Armastardo/OpenMiniRectangle/PCB/Pictures/Rename.png

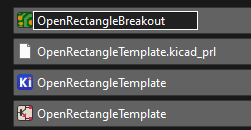
PCB/Pictures/Rename.png
