Armastardo/OpenMiniRectangle/PCB/model/RP2040_QFN_PACKAGE.STEP

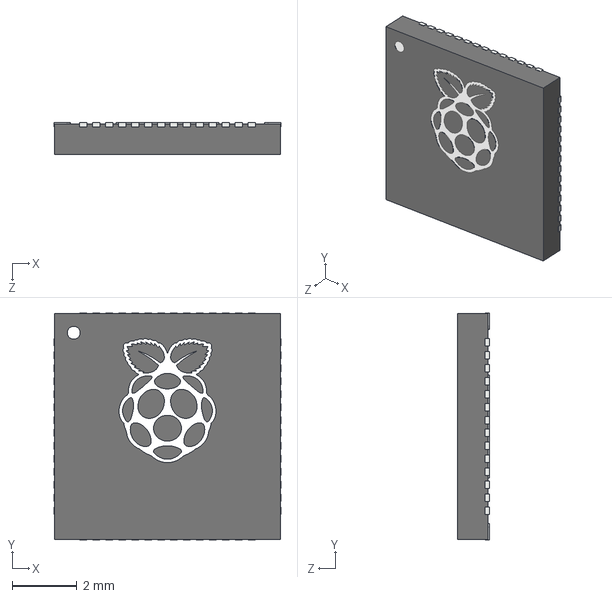
[picture p3: CAD file, 2023-03-23]
PCB/model/RP2040_QFN_PACKAGE.STEP
7.02 x 7.02 x 1.00 mm
