Armastardo/OpenMiniRectangle/PCB/OpenMiniRectangle.dxf

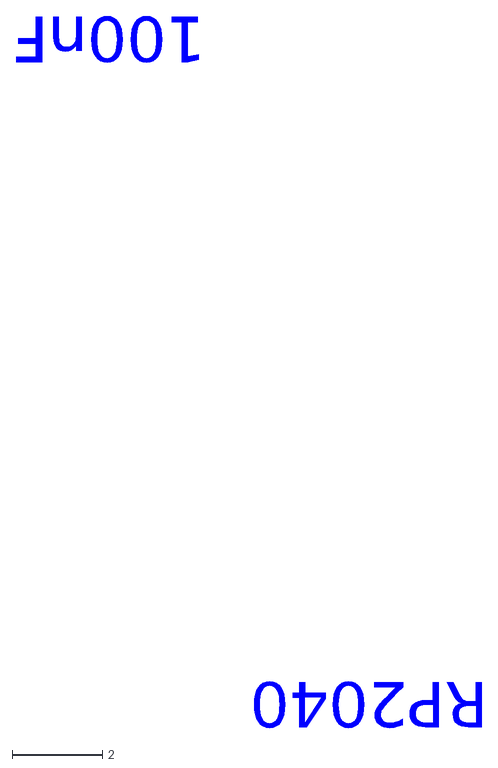
[picture p4: CAD file, 2023-03-23]
PCB/OpenMiniRectangle.dxf
100nF
RP2040
