Armastardo/OpenMiniRectangle/PCB/Resources/Small case reference.dxf

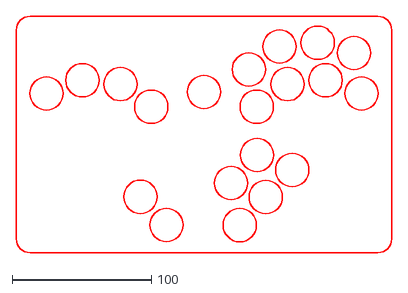
[picture p5: CAD file, 2023-03-23]
PCB/Resources/Small case reference.dxf
270.0 x 170.0
