Armastardo/OpenMiniRectangle/Case/Mini Rectangle v3.stl

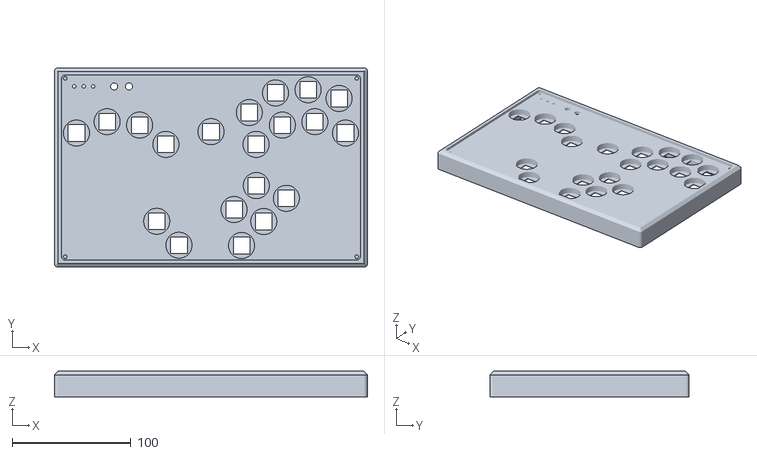
[picture p6: CAD file, 2023-07-12]
Case/Mini Rectangle v3.stl
263.6 x 168.0 x 21.5
