Armastardo/OpenMiniRectangle/(list of files, cad)

Other CAD files:
Case/BottomPanel.dwg
Case/TopPanel.dwg
