Armastardo/OpenMiniRectangle/DaughterBoard/MiniRectangleDB.kicad_pcb

## KiCad design DaughterBoard/MiniRectangleDB.kicad_pcb (2023-07-12)

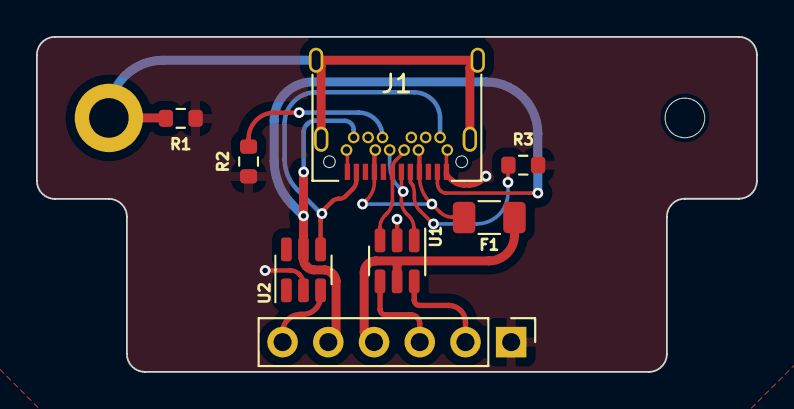
[picture p7: board MiniRectangleDB.kicad_pcb from above]

Board: 2 copper layers, 40.0 x 18.6 mm, 10 parts (0 on the bottom side), 13 nets.

Parts:
F1: 500 mA; Fuse_1206_3216Metric
H1: MountingHole; MountingHole_2.2mm_M2
H2: MountingHole_Pad; MountingHole_2.2mm_M2_DIN965_Pad
J1: USB C Connector; TYPE-C_24P_QCHT
J2: Conn_01x06; PinHeader_1x06_P2.54mm_Vertical
R1: 1M; R_0603_1608Metric
R2, R3: 5.1k; R_0603_1608Metric
U1, U2: USBLC6-2SC6; SOT-23-6

Connections:
3vCable: J1.A2 (TX1+), J1.B2 (TX2+), J2.5, U2.5 (VBUS)
+5V: F1.2, J2.4, U1.5 (VBUS)
D+: J2.2, U1.6 (I/O1)
D-: J2.3, U1.4 (I/O2)
DATA: J2.6, U2.3 (I/O2)
DATABUS: J1.A11 (RX2+), J1.B11 (RX1+), U2.4 (I/O2)
DBUS+: J1.A6 (D+), J1.B6 (D+), U1.1 (I/O1)
DBUS-: J1.A7 (D-), J1.B7 (D-), U1.3 (I/O2)
GND: J1.A1 (GND), J1.A12 (GND), J1.B1 (GND), J1.B12 (GND), J2.1, R1.1, R2.1, R3.2, U1.2 (GND), U2.2 (GND)
unnamed: F1.1, J1.A4 (VBUS), J1.A9 (VBUS), J1.B4 (VBUS), J1.B9 (VBUS)
unnamed: J1.A5 (CC1), R3.1
unnamed: J1.B5 (CC2), R2.2
unnamed: H2.1, J1.S1 (SHIELD), R1.2
