Armastardo/OpenMiniRectangle/PCB/OpenMiniRectangle.kicad_pcb

## KiCad design PCB/OpenMiniRectangle.kicad_pcb (2023-03-24)

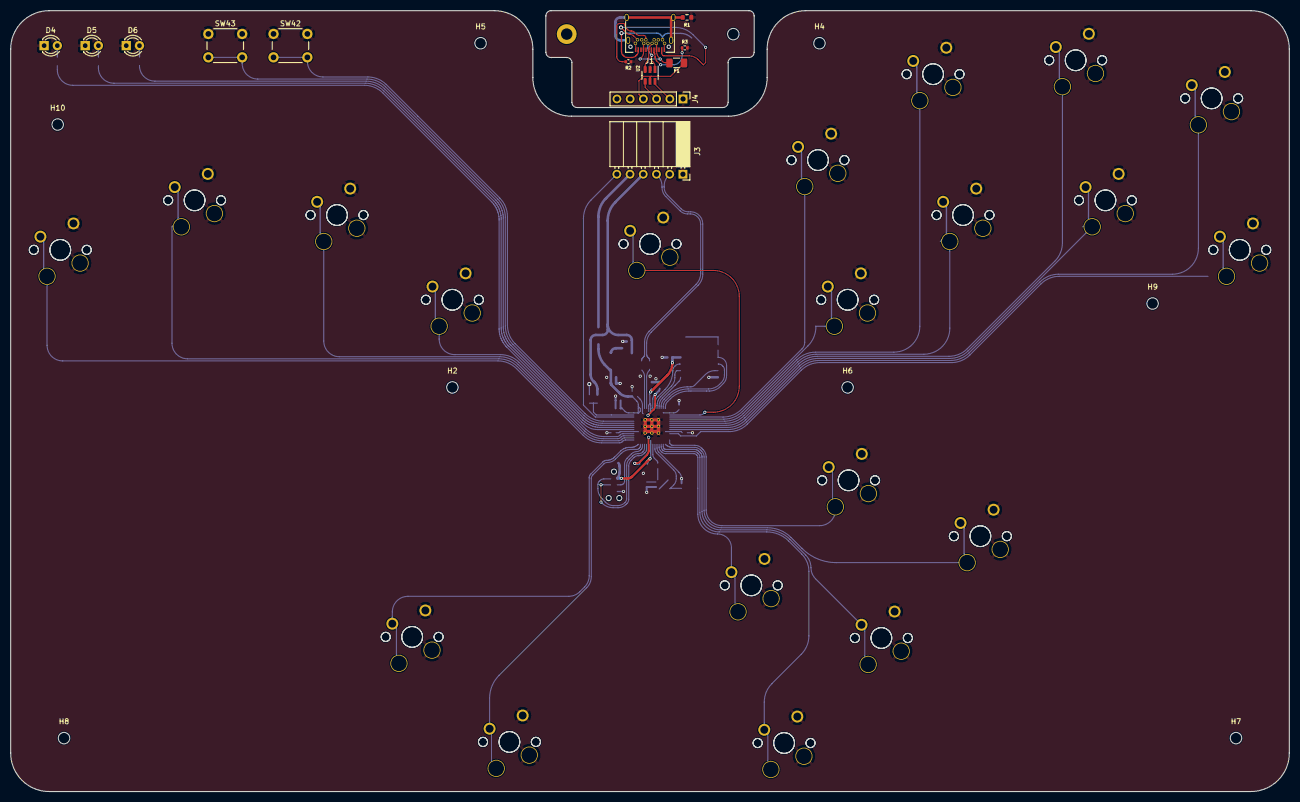
[picture p8: board OpenMiniRectangle.kicad_pcb from above]

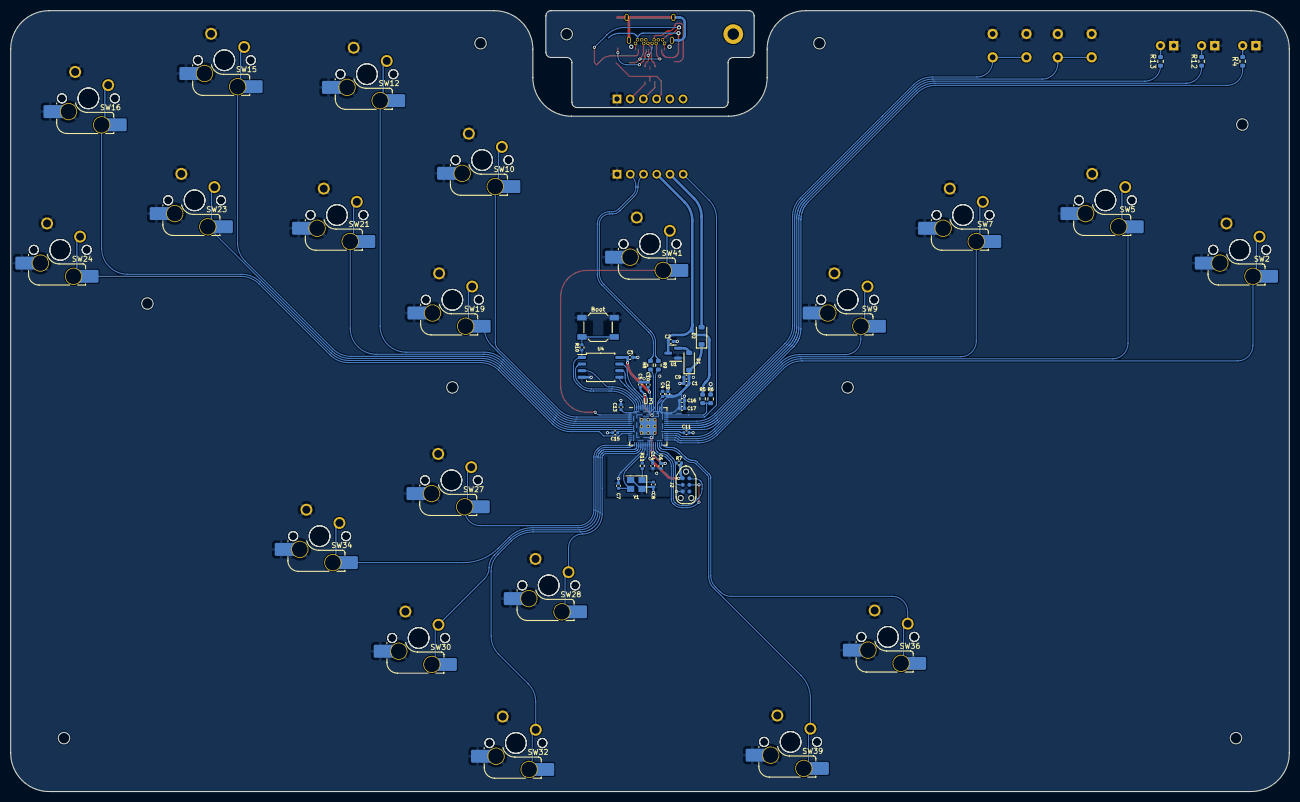
[picture p9: board OpenMiniRectangle.kicad_pcb from below]

Board: 2 copper layers, 245.6 x 150.0 mm, 98 parts (55 on the bottom side), 59 nets.

Parts:
C1, C2, C4, C10: 1uF; C_0402_1005Metric
C3, C5, C6, C11, C12, C13, C14, C15, C16, C17: 100nF; C_0402_1005Metric
C7, C8: 22pF; C_0402_1005Metric
C9: 10uF; C_0402_1005Metric
D1, D2: Schottky Diode; D_SOD-123
D4, D5, D6: LED; LED_D3.0mm
F1: 500 mA; Fuse_1206_3216Metric
H1, H2, H4, H5, H6, H7, H8, H9, H10: MountingHole; MountingHole_2.2mm_M2
H3: MountingHole_Pad; MountingHole_2.2mm_M2_DIN965_Pad
J1: USB C Connector; TYPE-C_24P_QCHT
J2: JTAG_TC2030; CON_TC2030_outlined
J3: Conn_01x06; PinSocket_1x06_P2.54mm_Horizontal
J4: Conn_01x06; PinHeader_1x06_P2.54mm_Vertical
R1: 1M; R_0603_1608Metric
R2, R3: 5.1k; R_0402_1005Metric
R4, R12, R13: 1k; R_0603_1608Metric
R5: 5.6k; R_0603_1608Metric
R6: 10k; R_0603_1608Metric
R7: 10k; R_0402_1005Metric
R8, R9: 27; R_0603_1608Metric
R10, R11: 1k; R_0402_1005Metric
SW1: Boot; SW_SPST_SKQG_WithStem
SW2, SW5, SW7, SW9, SW10, SW12, SW15, SW16, SW19, SW21, SW23, SW24, SW27, SW28, SW30, SW32, SW34, SW36, SW39, SW41: MX_SW_HS; SW_MX_HS_1u
SW3, SW4, SW6, SW8, SW11, SW13, SW14, SW17, SW18, SW20, SW22, SW25, SW26, SW29, SW31, SW33, SW35, SW37, SW38, SW40: MX_SW_solder; SW_MX_1u
SW42, SW43: SW_Push; SW_PUSH_6mm
U1: XC6206; SOT-23
U2: USBLC6-2SC6; SOT-23-6
U3: RP2040; RP2040-QFN-56
U4: W25Q128JVS; SOIC-8_5.23x5.23mm_P1.27mm
Y1: 12MHz; Crystal_SMD_3225-4Pin_3.2x2.5mm

Connections:
3vCable: D2.2 (A), J1.A2 (TX1+), J1.B2 (TX2+), J3.5, J4.5
+1V1: C4.1, C5.1, C6.1, U3.23 (DVDD), U3.45 (VREG_VOUT), U3.50 (DVDD)
+3V3: C1.2, C3.1, C9.1, C10.1, C11.1, C12.1, C13.1, C14.1, C15.1, C16.1, C17.1, D1.1 (K), D2.1 (K), J2.1 (VCC), R7.1, U3.1 (IOVDD), U3.10 (IOVDD), U3.22 (IOVDD), U3.33 (IOVDD), U3.42 (IOVDD), U3.43 (ADC_AVDD), U3.44 (VREG_VIN), U3.48 (USB_VDD), U3.49 (IOVDD), U4.8 (VCC)
+5V: C2.2, F1.2, J3.4, J4.4, R5.1, U1.3 (VI), U2.5 (VBUS)
/D_+: R8.2, U3.47 (D+)
/D_-: R9.2, U3.46 (D-)
/XTAL_O: C8.2, R11.1, Y1.1
/~USB_BOOT: R10.1, SW1.2
A: SW30.2, SW31.1, U3.16 (GPIO13)
B: SW18.1, SW19.2, U3.4 (GPIO2)
CS: R10.2, U3.56 (QSPI_SS_N), U4.1 (~CS)
C_DN: SW32.2, SW33.1, U3.17 (GPIO14)
C_LT: SW28.2, SW29.1, U3.18 (GPIO15)
C_RT: SW34.2, SW35.1, U3.15 (GPIO12)
C_UP: SW26.1, SW27.2, U3.14 (GPIO11)
D+: J3.2, J4.2, R8.1, U2.6 (I/O1)
D-: J3.3, J4.3, R9.1, U2.4 (I/O2)
DATA: J1.A11 (RX2+), J1.B11 (RX1+), J3.6, J4.6, U3.40 (GPIO28/ADC2)
DBUS+: J1.A6 (D+), J1.B6 (D+), U2.1 (I/O1)
DBUS-: J1.A7 (D-), J1.B7 (D-), U2.3 (I/O2)
DOWN: SW6.1, SW7.2, U3.31 (GPIO20)
GND: C1.1, C2.1, C3.2, C4.2, C5.2, C6.2, C7.1, C8.1, C9.2, C10.2, C11.2, C12.2, C13.2, C14.2, C15.2, C16.2, C17.2, D4.1 (K), D5.1 (K), D6.1 (K), J1.A1 (GND), J1.A12 (GND), J1.B1 (GND), J1.B12 (GND), J2.5 (GND), J3.1, J4.1, R1.1, R2.1, R3.2, R6.2, SW1.1, SW2.1, SW3.2, SW4.2, SW5.1, SW6.2, SW7.1, SW8.2, SW9.1, SW10.1, SW11.2, SW12.1, SW13.2, SW14.2, SW15.1, SW16.1, SW17.2, SW18.2, SW19.1, SW20.2, SW21.1, SW22.2, SW23.1, SW24.1, SW25.2, SW26.2, SW27.1, SW28.1, SW29.2, SW30.1, SW31.2, SW32.1, SW33.2, SW34.1, SW35.2, SW36.1, SW37.2, SW38.2, SW39.1, SW40.2, SW41.1, SW42.1, SW43.1, U1.1 (GND), U2.2 (GND), U3.19 (TESTEN), U3.57 (GND), U4.4 (GND), Y1.2, Y1.4
HOME: SW42.2, U3.38 (GPIO26/ADC0)
L: SW2.2, SW3.1, U3.29 (GPIO18)
LED1: R13.1, U3.36 (GPIO24)
LED2: R12.1, U3.35 (GPIO23)
LED3: R4.1, U3.34 (GPIO22)
LEFT: SW4.1, SW5.2, U3.30 (GPIO19)
LS: SW16.2, SW17.1, U3.9 (GPIO7)
M1: SW36.2, SW37.1, U3.28 (GPIO17)
M2: SW38.1, SW39.2, U3.27 (GPIO16)
MS: SW14.1, SW15.2, U3.7 (GPIO5)
unnamed: D1.2 (A), U1.2 (VO)
unnamed: D4.2 (A), R4.2
unnamed: D5.2 (A), R12.2
unnamed: D6.2 (A), R13.2
unnamed: F1.1, J1.A4 (VBUS), J1.A9 (VBUS), J1.B4 (VBUS), J1.B9 (VBUS)
unnamed: J1.A5 (CC1), R3.1
unnamed: J1.B5 (CC2), R2.2
unnamed: J1.S1 (SHIELD), R1.2
QSPI_CLK: U3.52 (QSPI_SCLK), U4.6 (CLK)
R: SW10.2, SW11.1, U3.3 (GPIO1)
RIGHT: SW8.1, SW9.2, U3.32 (GPIO21)
SD0: U3.53 (QSPI_SD0), U4.5 (DI(IO0))
SD1: U3.55 (QSPI_SD1), U4.2 (DO(IO1))
SD2: U3.54 (QSPI_SD2), U4.3 (IO2)
SD3: U3.51 (QSPI_SD3), U4.7 (IO3)
SELECT: SW43.2, U3.37 (GPIO25)
START: SW40.1, SW41.2, U3.2 (GPIO0)
SWCLK: J2.4 (SWCLK), U3.24 (SWCLK)
SWD: J2.2 (SWDIO), U3.25 (SWDIO)
UP: SW24.2, SW25.1, U3.11 (GPIO8)
VBUS_SENSE: R5.2, R6.1, U3.41 (GPIO29/ADC3)
X: SW20.1, SW21.2, U3.6 (GPIO4)
XTAL_IN: C7.2, U3.20 (XTAL_IN), Y1.3
XTAL_OUT: R11.2, U3.21 (XTAL_OUT)
Y: SW12.2, SW13.1, U3.5 (GPIO3)
Z: SW22.1, SW23.2, U3.8 (GPIO6)
~RESET: J2.3 (~RST), R7.2, U3.26 (~RUN)
