Armastardo/OpenMiniRectangle/(commit log)

2023-03-23 Most things on the main PCB connected
    [Buttons.kicad_sch, OpenMiniRectangle.dxf, OpenMiniRectangle.kicad_pcb, OpenMiniRectangle.kicad_sch, RP2040_QFN_PACKAGE.STEP, Small case reference.dxf]
2023-03-24 Added separated board for the DB
    [Buttons.kicad_sch, MiniRectangleDB.kicad_pcb, MiniRectangleDB.kicad_sch, OpenMiniRectangle.kicad_pcb, OpenMiniRectangle.kicad_sch]
2023-03-24 Finished main PCB
    [Buttons.kicad_sch, MiniRectangleDB.kicad_sch, OpenMiniRectangle.kicad_sch]
2023-07-12 Adjusted files
    [BottomPanel.dwg, Mini Rectangle v3.stl, MiniRectangleDB.kicad_pcb, MiniRectangleDB.kicad_sch, TopPanel.dwg]
2023-07-12 Adjusted .gitignore
    [bom.csv, designators.csv, positions.csv]
